SamihaFansur/3D-Printed-ESP32-Macropad/3D Model Repository/correct/esp32_case_base.stl

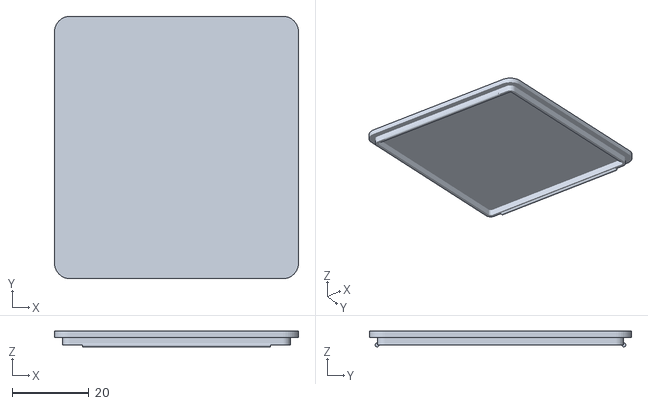
[picture p23: CAD file, 2024-06-12]
3D Model Repository/correct/esp32_case_base.stl
63.5 x 68.3 x 4.10
