SamihaFansur/3D-Printed-ESP32-Macropad/3D Model Repository/failures/hotswap_failed_1_diode_connection_issue.stl

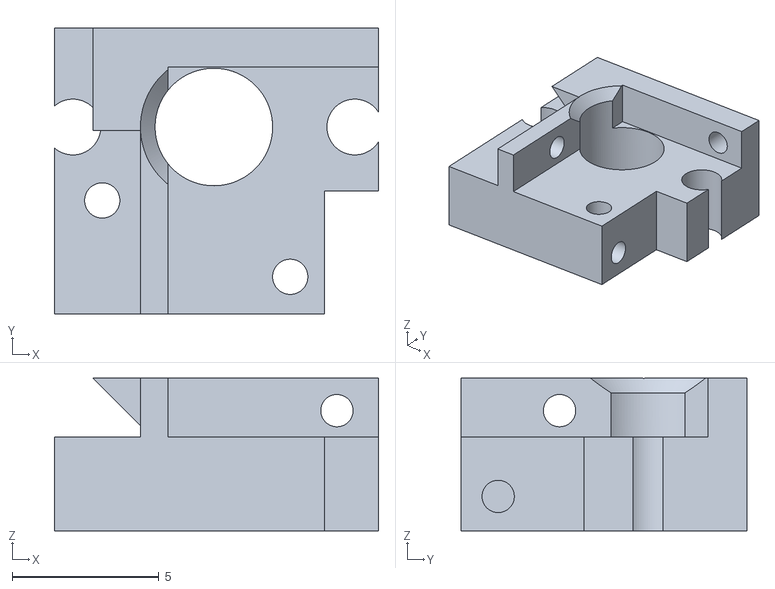
[picture p24: CAD file, 2024-06-12]
3D Model Repository/failures/hotswap_failed_1_diode_connection_issue.stl
11.0 x 9.75 x 5.20
