SamihaFansur/3D-Printed-ESP32-Macropad/3D Model Repository/correct/macropad_case.stl

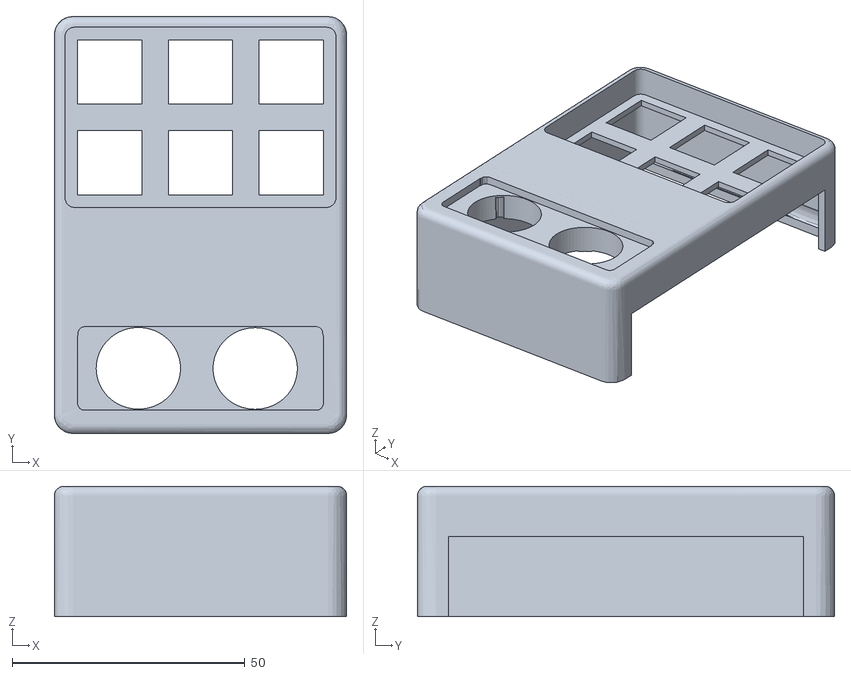
[picture p25: CAD file, 2024-06-12]
3D Model Repository/correct/macropad_case.stl
62.8 x 89.6 x 28.0
