SamihaFansur/3D-Printed-ESP32-Macropad/3D Model Repository/failures/case_for_all_components_not_enough_space.stl

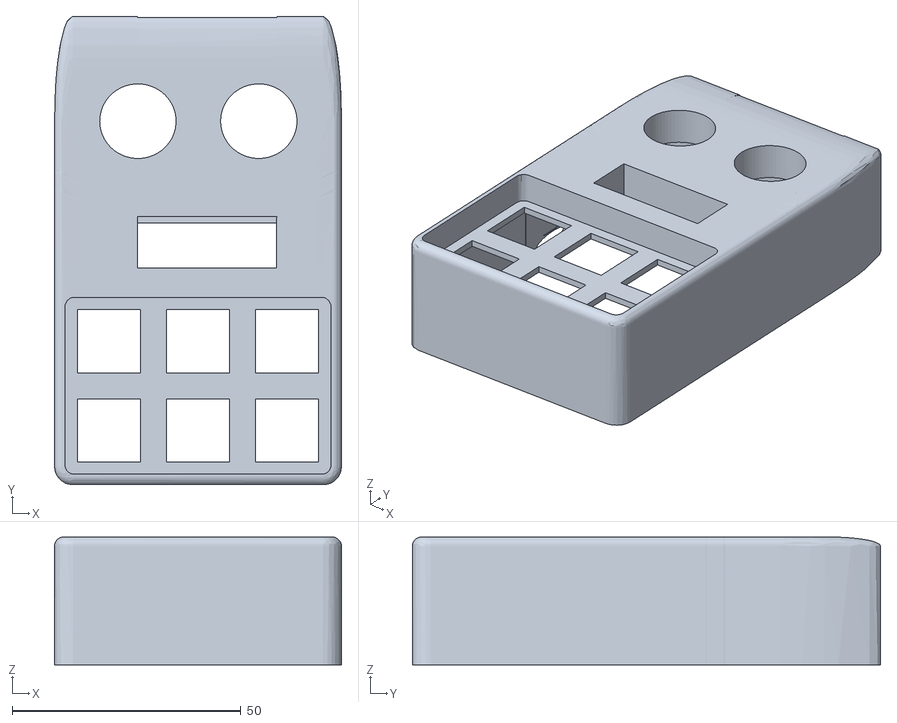
[picture p26: CAD file, 2024-06-12]
3D Model Repository/failures/case_for_all_components_not_enough_space.stl
62.8 x 102.5 x 28.0
