SamihaFansur/3D-Printed-ESP32-Macropad/3D Model Repository/correct/esp32_case.stl

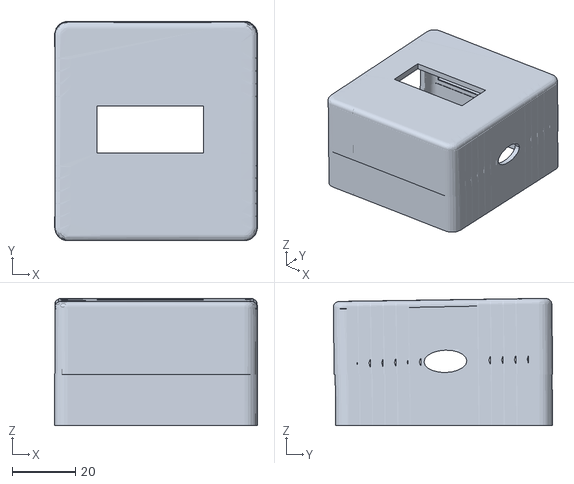
[picture p27: CAD file, 2024-06-12]
3D Model Repository/correct/esp32_case.stl
64.1 x 69.3 x 40.2
