SamihaFansur/3D-Printed-ESP32-Macropad/3D Model Repository/failures/hotswap_wires_dont_touch.stl

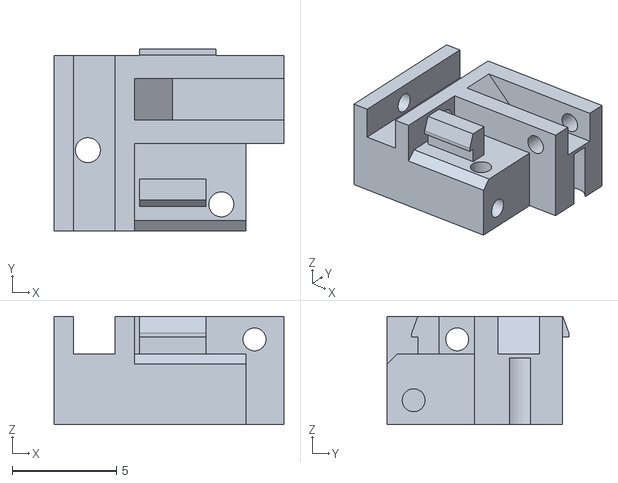
[picture p28: CAD file, 2024-06-12]
3D Model Repository/failures/hotswap_wires_dont_touch.stl
11.0 x 8.72 x 5.20
