SamihaFansur/3D-Printed-ESP32-Macropad/3D Model Repository/correct/macropad_case_base.stl

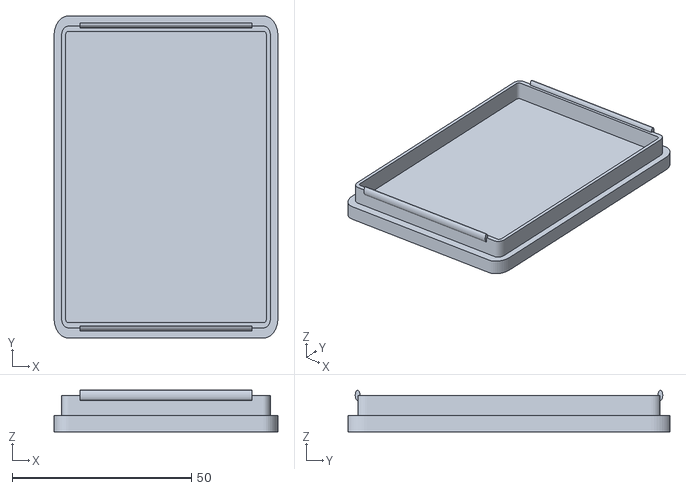
[picture p29: CAD file, 2024-06-12]
3D Model Repository/correct/macropad_case_base.stl
62.4 x 89.8 x 11.6
