SamihaFansur/3D-Printed-ESP32-Macropad/3D Model Repository/failures/macropad_case_no_cut_out_for_sensor.stl

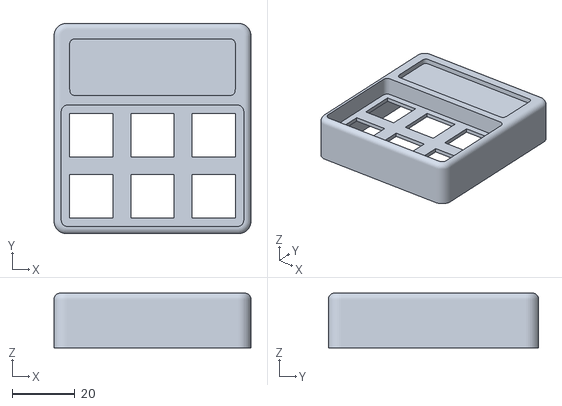
[picture p30: CAD file, 2024-06-12]
3D Model Repository/failures/macropad_case_no_cut_out_for_sensor.stl
62.8 x 67.1 x 17.5
