SamihaFansur/3D-Printed-ESP32-Macropad/3D Model Repository/correct/key.stl

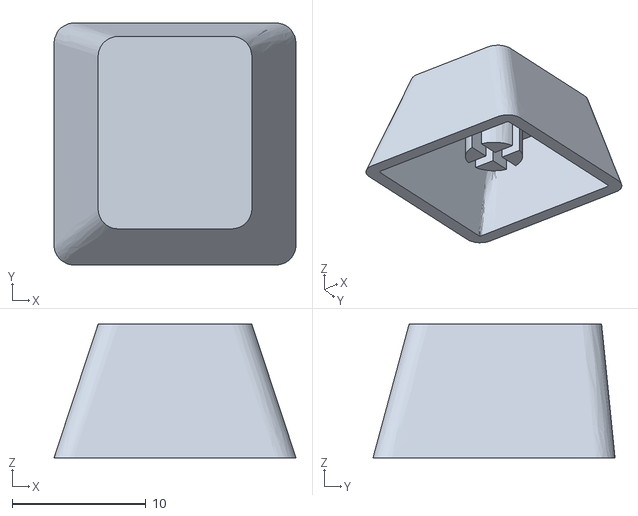
[picture p31: CAD file, 2024-06-12]
3D Model Repository/correct/key.stl
18.1 x 18.1 x 10.0
