SamihaFansur/3D-Printed-ESP32-Macropad/3D Model Repository/failures/hotswap_left_cover.stl

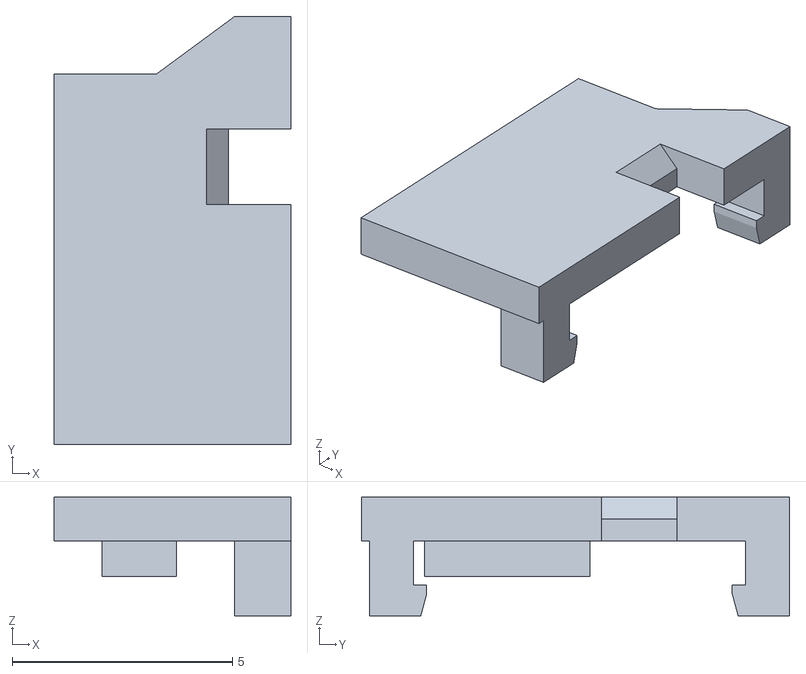
[picture p32: CAD file, 2024-06-12]
3D Model Repository/failures/hotswap_left_cover.stl
5.38 x 9.72 x 2.70
