SamihaFansur/3D-Printed-ESP32-Macropad/3D Model Repository/correct/final_hotswap_socket.stl

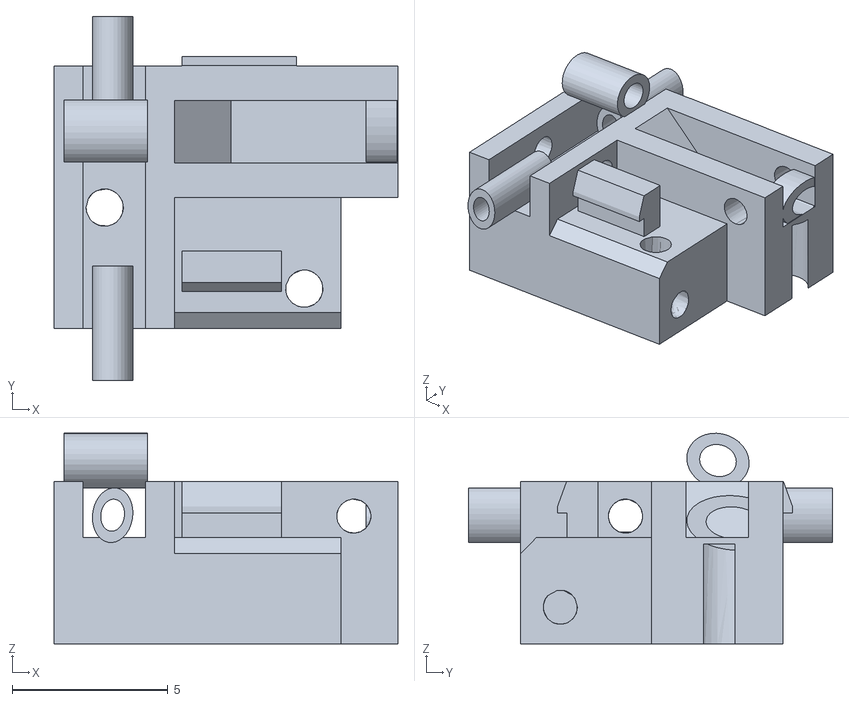
[picture p33: CAD file, 2024-06-12]
3D Model Repository/correct/final_hotswap_socket.stl
11.0 x 11.7 x 6.75
