SamihaFansur/3D-Printed-ESP32-Macropad/3D Model Repository/failures/macropad_case_not_enough_space_after_adding_sensor.stl

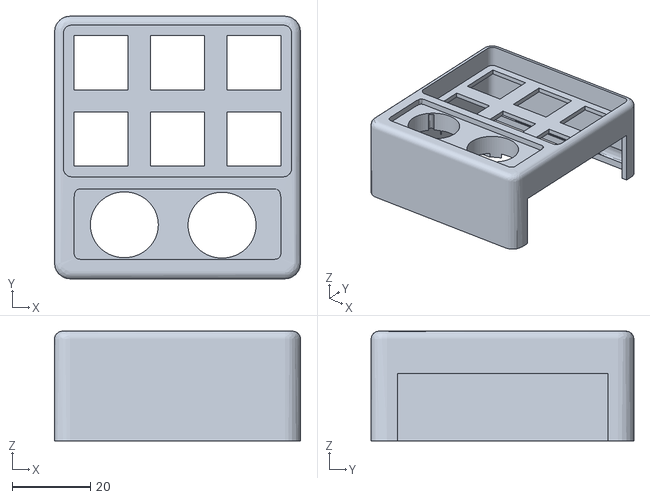
[picture p34: CAD file, 2024-06-12]
3D Model Repository/failures/macropad_case_not_enough_space_after_adding_sensor.stl
62.8 x 67.1 x 28.0
