SamihaFansur/3D-Printed-ESP32-Macropad/3D Model Repository/failures/hotswap_right_cover.stl

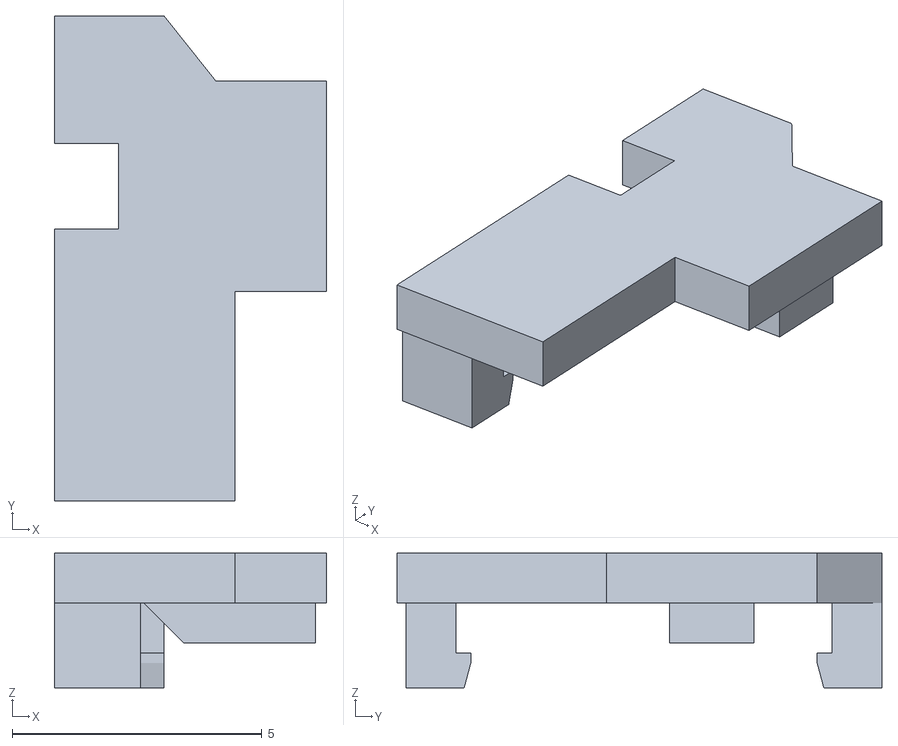
[picture p35: CAD file, 2024-06-12]
3D Model Repository/failures/hotswap_right_cover.stl
5.45 x 9.72 x 2.70
