SamihaFansur/3D-Printed-ESP32-Macropad/3D Model Repository/failures/esp32_case_port_hole_too_low_and_oled_screen_cutout_need_to_be_flushed_out.stl

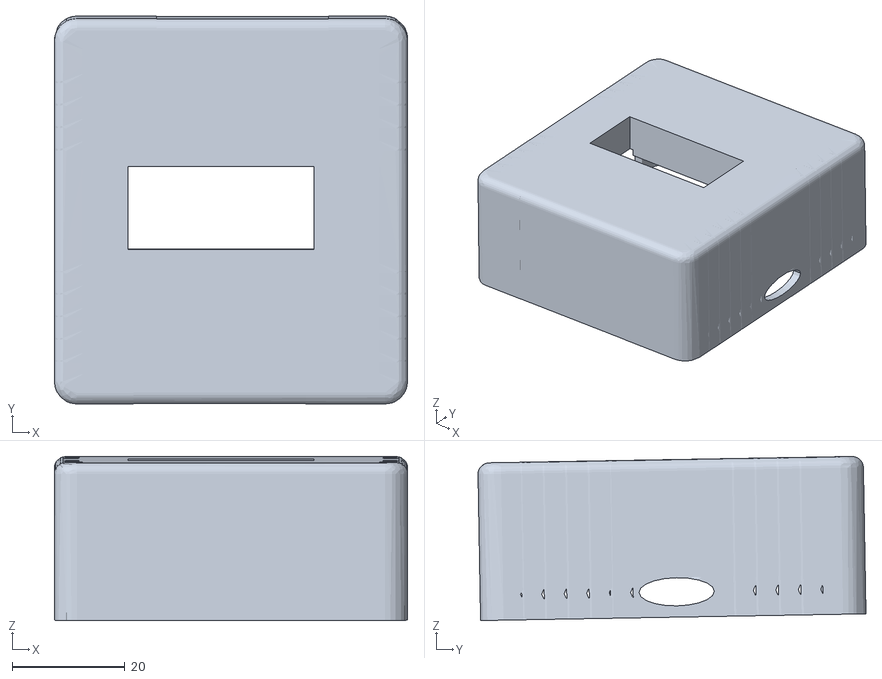
[picture p36: CAD file, 2024-06-12]
3D Model Repository/failures/esp32_case_port_hole_too_low_and_oled_screen_cutout_need_to_be_flushed_out.stl
62.8 x 68.9 x 29.2
