SamihaFansur/3D-Printed-ESP32-Macropad/3D Model Repository/failures/case_for_all_components_enough_space_but_not_aesthetically_pleasing.stl

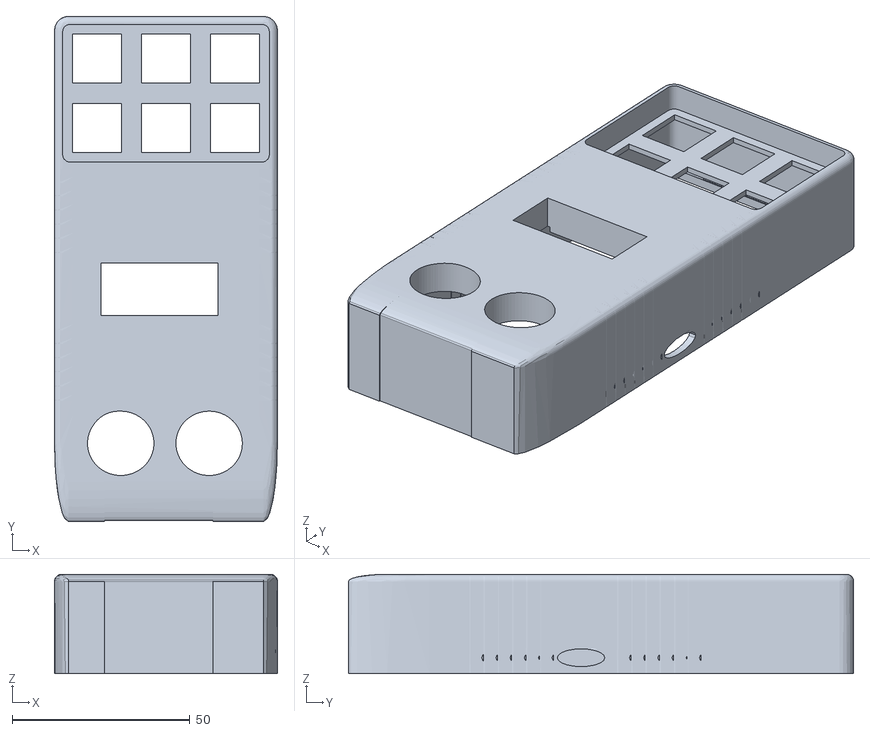
[picture p37: CAD file, 2024-06-12]
3D Model Repository/failures/case_for_all_components_enough_space_but_not_aesthetically_pleasing.stl
62.8 x 142.3 x 28.0
