SamihaFansur/3D-Printed-ESP32-Macropad/3D Model Repository/failures/bottom_cover.stl

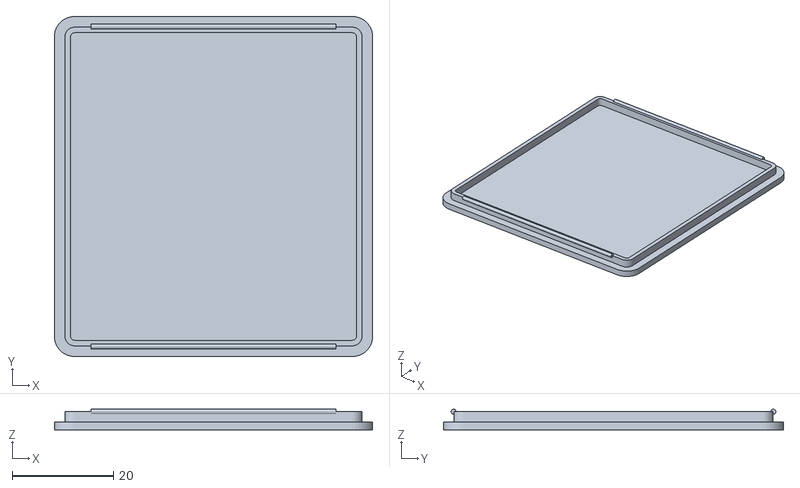
[picture p38: CAD file, 2024-06-12]
3D Model Repository/failures/bottom_cover.stl
62.8 x 67.1 x 4.10
